valfrid/OpenAudioLink/firmware/components/oal_audio/include/oal_playout.h

#pragma once

#include <stdbool.h>
#include <stddef.h>
#include <stdint.h>

#include "esp_err.h"
#include "oal_channel.h"

#ifdef __cplusplus
extern "C" {
#endif

/*
 * Playing received audio through an I²S DAC (docs/HARDWARE.md).
 *
 * Two clocks that nobody synchronised meet here. Packets arrive when the
 * radio delivers them — measured at 1.2 to 2.3 ms of jitter, occasionally
 * in bursts (LINK-MEASUREMENTS.md) — and the DAC consumes exactly 48 000
 * frames a second forever. A buffer between them is not an optimisation;
 * without one every scheduling hiccup is an audible click.
 *
 * So received packets go into a ring, and a separate task feeds the I²S
 * peripheral from it at the rate the hardware sets. The ring's depth is
 * the playout delay, and it is the price of not clicking.
 *
 * What this does not do yet is correct drift. The sender's idea of 48 kHz
 * and this DAC's differ by a few parts per million, so over hours the ring
 * slowly fills or empties. Both ends are handled — a full ring drops its
 * oldest frames, an empty one plays silence — and both are counted, so the
 * effect is visible rather than mysterious. Trimming the clock through the
 * APLL is decision 2's work and belongs with multi-speaker synchronisation
 * rather than here.
 */

typedef struct {
    int bclk_gpio;
    int ws_gpio;
    int dout_gpio;

    /** Frames per second. The RTP profile's 48 000 unless testing. */
    uint32_t sample_rate;

    /**
     * How much audio to gather before playing any of it. The whole
     * latency argument in one number: too little and ordinary jitter
     * empties the ring, too much and the speaker lags the room.
     *
     * Set against the longest gap a sender leaves rather than the
     * network's jitter — a PC waking on a 15.6 ms timer leaves a bigger
     * hole than Wi-Fi does. Zero takes the 100 ms default.
     */
    uint32_t target_ms;

    /** Which of the two channels this speaker plays (decision 10). */
    oal_channel_t channel;
} oal_playout_config_t;

typedef struct {
    bool running;             /* the I²S peripheral is up */
    bool playing;             /* the ring is primed and feeding it */
    uint32_t buffered_frames;
    uint32_t target_frames;
    uint32_t capacity_frames;
    uint64_t frames_played;
    uint32_t silence_frames;  /* inserted because the ring ran dry */
    uint32_t dropped_frames;  /* discarded because the ring was full */
    uint32_t underruns;       /* times it ran dry, however long each lasted */
    uint32_t trimmed_frames;  /* single frames dropped to walk the fill back down */
    uint32_t write_errors;    /* the I²S driver refused a write */
    oal_channel_t channel;
} oal_playout_state_t;

/**
 * Brings up the I²S peripheral and starts the playout task. The task runs
 * and writes silence whether or not anything is arriving: a DAC needs a
 * continuous bit clock to stay locked, and one that is started and stopped
 * with the audio clicks on every track.
 */
esp_err_t oal_playout_start(const oal_playout_config_t *config);

/**
 * Hands one packet's payload to the ring, applying the channel profile on
 * the way.
 *
 * @param payload L24 big-endian stereo, **modified in place** by the
 *                channel profile. The consumer has already verified it by
 *                the time this is called.
 * @param frames  frames, not bytes.
 *
 * Safe to call before the DAC has been started; it does nothing.
 */
void oal_playout_submit(uint8_t *payload, size_t frames);

void oal_playout_get(oal_playout_state_t *out);

/** True once the I²S peripheral is up. */
bool oal_playout_running(void);

#ifdef __cplusplus
}
#endif
