valfrid/OpenAudioLink/(commit log)

2026-07-27 Add protocol suite specifications (discovery, identity, control)
    Define protocol-suite 0.1 drafts: UDP multicast discovery with JSON
    announce/probe messages, the device identity and hardware-profile
    model, and the HTTP/JSON control and status API for the Phase 2.4
    command set. Port assignments and versioning rules are documented in
    protocol/README.md.
    Claude-Session: https://claude.ai/code/session_013Ep1dr3eARSjFWME619s7Y
2026-07-27 Add Windows Hub skeleton (Phase 2.2)
    .NET 8 solution with three projects:
    - OpenAudioLink.Core: device identity model, device registry with
    liveness tracking, and the discovery wire protocol (announce/probe)
    per protocol-suite 0.1.
    - OpenAudioLink.Hub: ASP.NET Core host with health endpoint, device
    inventory API, JSON configuration storage, discovery background
    service and a web UI shell. Runs as console app or Windows service.
    - OpenAudioLink.Core.Tests: xUnit coverage for identity, discovery
    parsing and registry liveness.
    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
2026-07-27 Add ESP-IDF test firmware skeleton (Phase 2.3)
    Portable oal_discovery component implementing the announce/probe
    protocol from protocol/DISCOVERY.md, plus a testnode project that
    boots, joins Wi-Fi (build-time credentials until USB provisioning)
    and announces itself so the Hub can discover it. Builds for both the
    temporary ESP32-C3 development boards and the ESP32-S3 reference
    target; no hardware-profile-specific code.
    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
2026-07-27 Add CI: Hub build/test and ESP-IDF firmware builds
    Builds and tests the Hub solution on Windows and Linux, and builds
    the testnode firmware for esp32c3 and esp32s3 with ESP-IDF v5.3.1.
    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
2026-07-27 Hello-world milestone: provisioning portal, control server, OTA
    Firmware:
    - oal_wifi: Wi-Fi credentials in NVS with a SoftAP provisioning portal
    fallback, so nodes are configured from a phone without any toolchain
    and no credentials ever enter the repository.
    - oal_control: HTTP control server on 41001 with /status, /reboot and
    /ota (pull-based esp_https_ota into the inactive OTA slot).
    - Two-OTA partition layout; firmware version 0.2.0.
    Hub:
    - FirmwareStore: upload, list (size + SHA-256) and serve images under
    /firmware for device OTA pulls.
    - DeviceCommandClient: reboot and OTA-start commands to devices, using
    the Hub address as seen from the device's subnet.
    - Web UI: firmware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
    [main.c]
2026-07-27 Specify RTP audio transport as an AES67-subset L24 profile
    Locks the audio payload to a publicly specified format (L24, 24-bit
    linear PCM per RFC 3190, 48 kHz stereo, big-endian) described by SDP,
    so any conforming RTP receiver can decode an OpenAudioLink stream and
    third-party software can verify a Producer before receiver firmware
    exists.
    Defaults to 5 ms packets rather than the AES67 1 ms baseline: at 1 ms
    an ESP32 must service 1000 packets per second over Wi-Fi for 4 ms of
    latency a multi-room system does not need. Unicast is the default for
    the same reason, since Wi-Fi multicast is unacknowledged and sent at a
    low basic rate.
    Documents the deviations from AES67 (no PTP, no RTCP in 0.1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
2026-07-27 Record Windows audio capture decision: WASAPI loopback
    Captures the target use case (play Spotify on the PC, stream to every
    receiver, PC keeps its own sound) and settles the capture mechanism
    before Phase 3 implementation.
    WASAPI loopback on the active render endpoint needs no virtual audio
    device: local playback continues, nothing is installed and nothing is
    reconfigured in Windows. Records why a third-party virtual cable and a
    custom driver were rejected, and notes process loopback capture as the
    later answer for per-application streaming.
    Also documents the constraints that follow: capture must run in the
    logged-in session rather than the session 0 service, the endpoint mix
    format must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
2026-07-27 Add RTP audio producer with test-tone stream (Phase 3 bring-up)
    Implements the wire side of protocol/AUDIO-RTP.md so the audio path can
    be verified with third-party receivers while the ADC/DAC boards are
    still in transit, and before WASAPI capture exists.
    Core:
    - AudioStreamFormat: reference format (stereo/48 kHz/L24/5 ms) with
    validation that rejects packet times which are not a whole number of
    frames or would fragment on a 1500-byte MTU.
    - RtpAudioPacketizer: RFC 3550 header plus big-endian L24/L16 payload.
    Timestamps advance by frames written rather than wall-clock time, so
    bursty sending still produces correctly timed audio.
    - SineToneSource: phase-continuous tone, the reference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
2026-07-27 Add test tone controls to the Hub web UI
    Makes the test tone a first-class diagnostic rather than a curl-only
    endpoint. Sending a tone to a receiver answers "is this speaker
    working?" without involving a source, which stays useful long after
    bring-up.
    The destination can now be a discovered device, an explicit address, or
    omitted entirely — in which case the tone is sent back to whoever made
    the request, so the UI can start a stream aimed at the machine the
    browser is running on without the user looking up an IP. Addressing by
    device id rather than address means the tone follows a device if DHCP
    moves it.
    Claude-Session: https://clau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
2026-07-27 Add WASAPI loopback capture as an RTP source
    Captures the Windows default output device and streams it as RTP, so
    audio playing on the PC reaches the receivers while local playback
    continues. No virtual audio device, nothing to install.
    - IAudioSource abstraction; the tone and system audio now share one
    sender, so the subtle catch-up pacing exists in one place only.
    - AudioRingBuffer bridges push-style capture to the paced pull-style
    sender. Both directions of rate mismatch are explicit: a writer that
    gets ahead drops the oldest samples so live audio stays current, and a
    reader that gets ahead is given silence. Both are counted and surfaced
    in the stream status.
    - SystemAudioSourc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
2026-07-27 Fix ring buffer concurrency test
    Two problems, both in the test rather than the buffer:
    - Task.WaitAll trips xUnit1031 (blocking task operations in a test
    method), which warnings-as-errors turns into a build failure; the test
    is now async and awaits with a timeout.
    - The sample total was not an exact multiple of the chunk size, so the
    writer sent 99,968 of the 100,000 samples the assertion balanced
    against. Sizes are now derived from chunk count, since the point of
    the test is that the counts balance exactly.
    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
2026-07-27 Add enclosures to the project with a board measurement sheet
    Sets up parametric OpenSCAD enclosures as a repository component:
    source is diffable and reviewable, and CI will export STLs as artifacts
    so no CAD software is needed to get a printable file.
    MEASUREMENTS.md is the input to all of it — a datum convention plus
    twelve measurements per board, each stated with why it matters, and the
    design decisions (headers vs direct wiring, stacked vs side by side,
    closure method) that affect geometry as much as the numbers do.
    Records two constraints that come from the project rather than taste:
    the antenna keep-out, and USB access without disassembly since the
    device lifecycle ends in USB reco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
2026-07-27 Keep a live stream alive through UDP send failures
    Two changes after the first real end-to-end run, where the packet
    counter stopped while the stream was up.
    Windows fails the next operation on a UDP socket with WSAECONNRESET
    once an ICMP port-unreachable arrives — which happens whenever the
    receiver is not listening yet, restarts, or closes. That killed the
    send loop for something that is not the sender's fault, so
    SIO_UDP_CONNRESET now disables it.
    A single failed datagram also no longer ends the stream: send errors
    are counted and the loop continues, since losing one packet of live
    audio is far better than losing the stream. Persistent failures are
    visible as a count rather than silen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
2026-07-27 Refresh Hub status when the tab regains focus
    Browsers throttle setInterval in background tabs, often to once a
    minute, so switching to another window froze the packet counter while
    the stream ran normally — which reads as a stalled stream. Refreshing
    on visibilitychange and focus means the figures are current whenever
    the page is actually being looked at.
    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
2026-07-27 Allow an explicit destination address in the Hub UI
    The dropdown could only target a discovered device or the computer
    showing the page, so streaming to a machine you cannot browse from
    required the API. A typed address now covers that, and takes precedence
    over the dropdown so an explicit destination is never silently ignored.
    Also clarifies the default option: "This computer" resolves to the
    machine displaying the page, not the one running the Hub, which matters
    as soon as the two are different.
    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
2026-07-27 List every discovered machine as a stream destination
    The dropdown excluded devices with the hub role, on the assumption
    destinations would only ever be receivers. A PC running a player is
    exactly what you target when checking the audio path across the
    network, and another Hub on the LAN is discovered already — so it
    should be selectable rather than requiring its address be typed.
    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
2026-07-27 Record what the audio path has actually been verified against
    The tone, system-audio capture and a cross-machine stream over Wi-Fi
    have all been confirmed against GStreamer as an independent receiver.
    Writing down what was exercised — and what was not — matters more than
    usual here, because the compiler and CI cannot tell the difference
    between code that works and code that merely builds.
    Also states plainly that a stream currently has a single destination,
    where the architecture calls for one Producer feeding several
    Consumers.
    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
2026-07-27 Stream to multiple destinations by unicast replication
    A Producer can now feed several Consumers, which is what multi-room
    actually requires. Every destination receives the identical packet —
    same SSRC, sequence and timestamp — so receivers applying the same
    playout delay stay aligned with each other. One unreachable receiver no
    longer ends the stream for the rest.
    Destinations are given as a list where each entry is either a device id
    or an IP address: naming a device means the address follows it if DHCP
    moves it, while a literal address covers machines that are not
    OpenAudioLink devices at all, such as a PC running a player. With none
    given the caller is the destination, so the browse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
2026-07-27 Record source-placement rationale and future radio roles
    Captures why the Hub exists at all — Spotify Connect cannot run on an
    ESP — and that the founding use case was a vinyl rig streaming to party
    speakers with no PC involved. That history is what makes the Hub
    optional a return rather than a new direction, and it was recorded
    nowhere.
    Adds internet radio and DAB as future Producer roles. Both fit the
    existing role model without architectural change, but they are
    different engineering problems: internet radio is pure software on the
    ESP, while DAB needs an RF tuner module feeding I2S and then resembles
    the Analog Source.
    Notes the two things worth settling before committing to intern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
2026-07-27 Place internet radio on Windows rather than either platform
    Decoding competes with unicast replication for one chip and one radio,
    while a PC already has the headroom that makes stream buffering robust.
    An ESP32 implementation stays possible but is not the plan, and nothing
    is scheduled either way.
    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
2026-07-27 Send the firmware console to the native USB port
    Both the ESP32-C3 and ESP32-S3 talk to a PC over their built-in USB
    Serial/JTAG peripheral, but ESP-IDF defaults the console to UART0 —
    which on the Super Mini boards is not wired to the USB connector. The
    board therefore ran correctly and printed nothing at all, which makes
    every other problem undiagnosable.
    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
2026-07-28 Make the test node diagnosable on real hardware
    Three changes, all prompted by a C3 that ran and could not tell anyone
    what it was doing.
    start_portal checks each call individually and logs which one failed,
    instead of ESP_ERROR_CHECK aborting silently. A device that cannot start
    its setup portal is unrecoverable in the field, so it must report the
    reason rather than reboot. The soft-AP channel is now set explicitly,
    since 0 is not valid on all IDF versions.
    A heartbeat task logs uptime, free heap and Wi-Fi mode every five
    seconds. USB Serial/JTAG keeps no buffer for a terminal attached after
    boot, so a console opened during normal running was completely blank and
    indistinguishable from a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
    [main.c]
2026-07-28 Record deployment modes and the capacity order of attack
    Standalone "party mode" is a distinct deployment, not a fallback: gear
    carried to a venue with no router, no Hub and no internet, where the
    Producer creates its own access point and receivers join it. It reuses
    the soft-AP already built for provisioning as an operating mode, and is
    the strongest test of the Hub-optional decision — if it works, no hidden
    dependency on the Hub survived.
    Notes the open question it raises: a receiver configured for a home
    network must join the party network unattended, which suggests a
    fallback chain of configured network, then an OpenAudioLink access
    point, then its own setup portal. Recognising an Ope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
2026-07-28 Record single-image, role-in-NVS design with S3 as the only baseline
    A node runs one firmware image with its role read from NVS at boot
    rather than compiled in, written during provisioning and defaulting to
    receiver. Roles are logical rather than device-bound, so baking one into
    a binary contradicts the architecture; it also means OTA cannot push the
    wrong role, the firmware store holds one image, and a node changes role
    by configuration instead of a USB trip.
    Staying on one chip is what keeps it to a single image for the whole
    system — mixed silicon would mean two forever. The C3 is recorded as
    temporary scaffolding with an explicit removal trigger rather than
    something left to drift.
    F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
2026-07-28 Adopt Seeed XIAO ESP32S3 as the preferred node hardware
    External U.FL antenna with no PCB antenna at all, dual-core 240 MHz,
    published schematics and mechanical models, and integrated Li-Po
    charging. The antenna removes the enclosure keep-out constraint outright
    rather than requiring design around it, the dual core is the property
    decision 2 relies on, published mechanical data feeds the enclosure work
    directly, and battery charging turns standalone party mode from a
    mains-tethered idea into a portable one.
    Hardware profiles now name the board as well as the audio hardware,
    since pin mapping and antenna arrangement both differ between boards.
    The Super Mini becomes secondary and the C3 keep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
2026-07-28 Log why provisioning fails to persist
    The node stays in soft-AP mode after credentials are entered, so it
    never joins the network and never reaches the Hub. Neither the save nor
    the load path said anything, leaving no way to tell which one failed.
    - load_credentials now reports whether NVS opened, whether an SSID was
    found, and the error when not.
    - The save handler logs the content length, reads the body until the
    declared length is satisfied rather than assuming a single read, and
    reports a missing ssid field with its parse error.
    - A boot-time NVS erase is now logged loudly, because it silently
    discards stored credentials — if it happens every boot the device can
    never be pro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
    [main.c]
2026-07-28 Fix provisioning form rejected by mobile browsers
    Two separate faults stopped credentials ever reaching NVS, both visible
    in the device log as HTTP errors rather than anything about storage.
    405: the phone submits the form as GET, putting the fields in the query
    string, and only POST was registered for /save. Both shapes are now
    accepted — rejecting one leaves the user unable to provision the device
    at all, which is not a reasonable place to be strict.
    431: ESP-IDF's HTTP server allows 512 bytes of request headers by
    default, and a modern mobile browser exceeds that easily with its
    User-Agent, Accept and sec-ch-* headers. Requests were rejected before
    any handler ran. Raised to 2048, wit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
2026-07-28 Report node state in every heartbeat, not just at boot
    Catching the boot log over native USB is unreliable: the port dies with
    each reset and the console reattaches after the interesting lines have
    already gone, so whether the access point actually started was
    unknowable from a console opened afterwards.
    The heartbeat now carries the answer — in AP mode the SSID, channel and
    client count; in STA mode the joined network, RSSI and IP address, or
    that it is not joined. Connecting at any moment now tells you the node's
    full network state instead of a bare mode number.
    Claude-Session: https://claude.ai/code/session_013Ep1dr3eARSjFWME619s7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
    [main.c]
2026-07-28 Add a radio self-check to the setup portal
    The access point reports as configured and started — esp_wifi_ap_get_sta_list
    succeeds rather than erroring — yet nothing can associate with it even
    when given the exact SSID manually. That separates logic from radio, and
    nothing in the logs distinguishes a working transmitter from a broken one.
    The node now scans once after the portal comes up and logs the networks
    it can hear with channel and RSSI, plus its own maximum transmit power.
    Hearing the surrounding networks proves receive works and points at
    transmit, antenna or association; hearing nothing in a normal home
    implicates the radio itself. The portal runs in AP+STA so the scan is
    possib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
2026-07-29 Revert the portal to plain AP mode so DHCP works
    The radio self-check needed the station interface up in order to scan,
    so the portal was switched to AP+STA. With both interfaces active a
    client associates at layer 2 but the access point's DHCP server never
    issues a lease: the phone joins, waits, reports that it could not
    connect, and drops the network. The join appears in the log with no
    DHCP assignment after it.
    The self-check has served its purpose — flashing ESPHome onto the first
    board established that its transmitter was faulty — so the scan is
    removed rather than worked around, and only the transmit-power report is
    kept.
    Cla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
2026-07-29 Bump test node firmware to 0.2.1
    The running build and the next one were both 0.2.0, so an over-the-air
    update would complete with nothing in the Hub's device table changing —
    leaving no way to tell whether it actually installed. The version is
    what makes an OTA verifiable from the UI, so it moves with this build,
    which also carries the AP-mode DHCP fix.
    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
    [main.c]
2026-07-29 Add Windows service install scripts for the Hub
    A machine that hosts the Hub permanently should run it as a service that
    survives reboots, so the artifact now ships install and uninstall
    scripts.
    The service starts automatically (delayed, so the network stack is up
    before discovery binds its multicast socket) and restarts after a crash.
    State goes to ProgramData rather than beside the executable, so
    re-running the installer to upgrade keeps the Hub's identity and
    uploaded firmware. Firewall rules for the web UI and discovery are
    created too, since a headless server has nobody to click the prompt.
    Documented alongside it: capturing the machine's audio does not work
    from a service, because s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
2026-07-29 Record that multiple Hub instances are a normal deployment
    A server instance running as a service handles Controller and
    Provisioner work, while any PC whose audio should be streamed runs its
    own instance in a logged-in session — forced by capture not working in
    session 0, and consistent with roles being logical rather than tied to
    devices.
    Choosing which roles an instance takes is deferred; every instance
    offers what it can for now. Notes the consequences that follow: Hubs
    appear to each other as devices, there is no single Controller, and
    nothing yet stops two instances streaming to the same receiver — which
    the receiver-held claim from decision 1 is meant to resolve, for Hubs
    exactly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
2026-07-29 Document PowerShell friction around the service installer
    Running the installer needs three things the earlier instructions did
    not mention, all of them PowerShell behaviour rather than ours: the .\
    prefix, since PowerShell will not run a script from the current
    directory without an explicit path; Unblock-File, because scripts
    extracted from a downloaded zip carry the internet mark and are refused
    under the default RemoteSigned policy; and an elevated prompt, without
    which the script stops immediately.
    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
2026-07-29 Correct the Set-ExecutionPolicy syntax in the service instructions
    Bypass is a value for -ExecutionPolicy rather than a switch, so the
    documented command failed with a parameter binding error. Also notes
    that an elevated prompt opens in system32, so the cd is needed even when
    the previous window was already in the right folder.
    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
2026-07-29 Reject firmware uploads that cannot be installed over the air
    The merged flash image and the OTA application image both begin with the
    same 0xE9 magic, so uploading the wrong one was accepted silently and
    then failed on the device — where it is far more expensive to diagnose.
    An ESP-IDF application image carries an esp_app_desc_t whose magic word
    sits at offset 0x20; a merged image has the bootloader there instead.
    Checking that distinguishes them exactly, and the rejection message
    names the file to upload instead.
    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
2026-07-29 Probe devices periodically so liveness survives multicast loss
    A node joined and announcing every five seconds still showed offline in
    the UI: announces are multicast, and Wi-Fi neither acknowledges nor
    retransmits them, so at around -70 dBm enough are lost that a healthy
    device flaps. The same reasoning that made unicast the default for audio
    applies to the control plane, and had not been carried across.
    The protocol already had the answer — devices reply to a probe by
    unicast — but the Hub only probed at startup. It now probes every five
    seconds, by multicast to find new devices and by unicast to those it
    already knows, so both the request and the reply get link-layer retries.
    No firm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
2026-07-29 Stop the API being served from browser cache
    Device liveness and stream counters are only useful if they are current,
    and a cached reading is indistinguishable from a dead device — which is
    exactly the ambiguity that made a flapping node hard to diagnose. API
    responses now carry no-store, and the UI's own fetches ask for it too.
    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
2026-07-29 Serve OTA from an address the device can reach
    The Hub picked the firmware URL host by connecting a UDP socket to the
    device and reading the socket's local address. That asks the routing
    table which interface it prefers, which is a different question. On a
    host running Tailscale it returned the CGNAT address 100.119.101.42, so
    the node was told to fetch from an address that does not exist on its
    network and the download failed at connect:
    E esp-tls: [sock=59] delayed connect error: Software caused connection abort
    E esp_https_ota: Failed to open HTTP connection: ESP_ERR_HTTP_CONNECT
    Choose by subnet instead: of this host's addresses, use one whose network
    contains the device — reacha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
2026-07-29 Show which version a firmware image contains
    An OTA that installs the version already running completes normally,
    reboots, and leaves the device reporting what it reported before — the
    node just did exactly that, taking a stale CI artifact from 0.2.0 to
    0.2.0. Nothing in the Hub distinguished that from an update that worked.
    The image header carries an esp_app_desc_t with the version, project
    name, build time and IDF version. Read it and show version and build
    time in the firmware table, and the version in the image picker, where
    choosing the wrong file is still recoverable.
    For that to mean anything the header version has to be the version the
    node announces, and it was not: FIRMWARE_VE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
    [main.c]
2026-07-29 Join the strongest mesh node, not the first to answer
    In a mesh every node advertises the same SSID under a different BSSID,
    so joining the network means choosing between them. The STA config was
    zero-initialised, which selects WIFI_FAST_SCAN: the driver takes the
    first node that answers and never compares. sort_method is ignored in
    that mode — there is nothing to sort — so the WIFI_CONNECT_AP_BY_SIGNAL
    that the zeroed struct also happens to select did nothing.
    The driver probes its remembered channel first, so a node that once
    landed on a distant mesh point goes back to it after every reboot. A
    test node 2 m from one ZenWiFi point sat at -77 dBm on the far one,
    having read -55 on the n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
    [main.c]
2026-07-29 Keep discovery alive when a device reboots
    Probing devices by unicast means regularly sending to a device that is
    rebooting — after an update, especially — and a rebooting device answers
    with ICMP port-unreachable. Windows fails the next operation on the
    sending UDP socket with WSAECONNRESET. RtpStreamer already suppresses
    that; the discovery socket never did, and it is the socket the Hub hears
    every other device on.
    The damage was in the loops. ProbeLoopAsync caught Exception, logged
    "Probe loop stopped" and left the loop, so one send to a rebooting node
    ended probing permanently. AnnounceLoopAsync caught only cancellation, so
    a SocketException escaped into Task.WhenAll and faulted Exe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
2026-07-29 Bind test sockets to loopback, not the any-address
    The new discovery socket tests bound with UdpClient(0, InterNetwork),
    whose LocalEndPoint is 0.0.0.0 — so they sent to 0.0.0.0. Windows
    rejects that with WSAEADDRNOTAVAIL; Linux reads it as localhost, which
    is why only the Windows leg failed. Bind to loopback so the endpoint is
    a real address to send to.
    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
2026-07-29 Hold node roles in NVS as a set, in the architecture's words
    Decision 5 says one firmware image with the role read from NVS. Two
    identical S3 boards where one sends and one receives is the case that
    forces it, so this stops being deferred work.
    Two things were called "role". ARCHITECTURE.md section 2 defines
    capabilities — controller, producer, consumer, provisioner — and says a
    device may implement several. The wire had a single string with a
    different vocabulary: receiver, analog-source, hub. One concept, two
    names, and the single field could not express the analog source that
    also plays, which decision 5 requires.
    The wire now uses the architecture's names and carries a set. Roles l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
2026-07-29 Import DeviceRole in the discovery message tests
    The rename put DeviceRole.Consumer into a file that did not reference the
    Devices namespace, so only the test project failed to compile.
    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
2026-07-29 Measure the link: RTP loss, jitter, duplicates and reordering
    The instrument for the ESP-to-ESP test. A consumer with no DAC attached
    can still answer what decides the architecture: whether a producer holds
    200 packets per second with a busy radio, what an RSSI costs in loss, and
    how deep a jitter buffer must be.
    Loss and jitter follow RFC 3550 appendices A.1 and A.8, so the numbers
    mean what every other RTP tool means by them. Duplicates and reordering
    are counted separately, which RFC 3550 does not do — on Wi-Fi they have
    different causes and different fixes, and one number hides which is
    happening. A 64-bit window of recent sequence numbers is what tells them
    apart.
    Three cases would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
    [oal_rtp_stats.c, oal_rtp_stats.h]
2026-07-30 Record alternative Consumers as decision 8
    ARCHITECTURE.md lists "I2S DAC output" under the Consumer's
    responsibilities, which reads as though the role dictates the output. It
    does not: a Consumer receives RTP, buffers it, corrects drift and plays
    it, and how samples leave the device belongs to the hardware profile.
    Alternative Consumers are therefore additive — new profiles, not a new
    architecture.
    Three are recorded so they are not re-derived later: a USB Audio Class
    dongle DAC driven by an ESP32-S3 in host mode, a PC Consumer
    application, and a Raspberry Pi.
    The USB option carries the obstacles, and they are written down because
    they decide whether it is worth attempting at all. VBUS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
2026-07-30 Name nodes by MAC suffix so identical boards are distinguishable
    One firmware image runs on every node (decision 5), so two boards
    flashed from the same file both announced "testnode". Their ids differ,
    so the Hub keeps them apart correctly, but the device list shows two
    identical rows and the stream destination list offers the same name
    twice — with two S3 boards on the bench, no way to tell the producer
    from the consumer.
    Append the same three MAC bytes that already name the setup access
    point, so a node in the device list is recognisably the one just
    provisioned through OpenAudioLink-XXXXXX.
    Claude-Session: https://claude.ai/code/s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
    [main.c]
2026-07-30 Build the portal SSID from the station MAC, like everything else
    The MAC suffix was meant to make the network you provision through and
    the node that then appears recognisably the same board. It did not: the
    portal read ESP_MAC_WIFI_SOFTAP while the identity and node name read
    ESP_MAC_WIFI_STA, and those differ by one in the last byte. A board with
    base MAC 1c:db:d4:43:54:58 offered OpenAudioLink-435459 and then
    announced itself as testnode-435458 — close enough to look like the same
    number and different enough to send you to the wrong board.
    One source for the label, the same one identity already uses.
    Claude-Session: https://claude.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
2026-07-30 Ask for name and role at provisioning, and let the password be seen
    Provisioning is the one moment the board is in your hands and you know
    which one it is. It now asks for everything that distinguishes it — the
    network, a name, and what the node is for — instead of only the network,
    so two identical boards become a producer and a consumer without a
    second trip through the Hub afterwards.
    The password can be revealed with a checkbox. It is typed once, alone,
    in front of a board, and a silent typo costs a failed join and a full
    re-provision cycle; that is a worse outcome than the nobody standing
    behind you.
    Name and roles are stored in NVS beside the credentials. Both are
    optional: the f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
    [main.c]
2026-07-30 Drop the ESP32-C3 target and size the flash to the real board
    Decision 5 removed the C3 target on a trigger — S3 hardware verified —
    rather than by drift. Two XIAO ESP32S3 boards are flashed, provisioned
    from a phone, discovered by the Hub and holding distinct producer and
    consumer roles from one image, so the trigger is met.
    With one target left, the partition table can be sized to the board
    instead of to the smallest chip that ever ran this. The flashing log
    confirmed what decision 6 could not: flash ID 0xC84017 is GigaDevice
    with capacity byte 0x17, so 8 MB, alongside 8 MB embedded PSRAM.
    The built-in two-OTA table caps every app partition at 1 MB whatever the
    chip, which is why the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
    [partitions.csv]
2026-07-30 Show uptime, SSID, BSSID and signal in the device list
    Diagnosing a mesh from a serial console one board at a time is how the
    last two evenings went. The device list now carries what those sessions
    were actually looking for.
    The BSSID is the point, not the RSSI. Every access point in a mesh
    advertises the same SSID, so signal strength alone cannot tell a node far
    from the right node from one attached to the wrong one — which is exactly
    the state a board sat in at -77 dBm two metres from a stronger point, and
    it took a firmware change to even see it. Signal is coloured against what
    a stream needs: a 2.4 Mbit/s unicast has margin above about -65 dBm and
    none below -75.
    This goes on the con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
2026-07-30 Stream RTP between nodes from a synthetic source
    The measurement rig for the link, ahead of the ADC and DAC. A producer
    generates the real profile — L24 stereo, 48 kHz, 5 ms packets, 200 a
    second, 1452 bytes on the wire — and sends it straight to the consumers
    the Hub names. The Hub coordinates and does not relay.
    The synthetic source is a pattern derived from each frame's absolute
    index, not a tone. A consumer can recompute every sample it should have
    received and count what differs, which catches corruption, truncation
    and misaligned payloads that a sequence-number check cannot see. A sine
    is available for when a DAC exists and something is worth listening to.
    Both ends report, becau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
    [main.c, oal_rtp.c, oal_rtp.h, oal_stream.h, oal_stream_consumer.c, oal_stream_producer.c]
2026-07-31 Put the link test's feedback under the link test
    Pressing Start with nothing selected in the To list wrote "Pick at least
    one destination" to the shared message line — which sits below the
    Firmware section, three screens away. From the panel the button simply
    looked dead.
    Messages for this panel now go to the status line directly beneath it,
    in red when something is wrong.
    The list also selects every consumer the first time it is populated.
    Testing all of them is the common case, and a populated list with
    nothing selected looks identical to a populated list with everything
    selected — which is precisely the state that made Start appear to do
    nothing.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
2026-07-31 Turn off Wi-Fi power save; it is costing packets
    The first measured link between two nodes on the same access point at
    -61 dBm lost 0.24% of packets and showed 2.04 ms of jitter. That is 220
    ms of missing audio over 92 seconds, a gap every two seconds, and far
    worse than the signal deserves.
    Every boot log has carried "wifi:pm start, type: 1" — modem sleep. The
    radio wakes on the beacon and the access point buffers unicast frames in
    between. That suits a device exchanging occasional control messages and
    is actively wrong for one taking 200 packets a second, and it fits the
    signature: steady low-level loss with inflated jitter and no reordering
    or corruption at all.
    The producer meanwhile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
2026-07-31 Measure the shape of the loss, not only the amount
    Turning off power save halved it: 0.240% to 0.111%, jitter 2.04 ms to
    1.19 ms. Real, and not enough — 38 packets is still 190 ms of missing
    audio over 171 seconds.
    But the total does not say what to do next. Thirty-eight isolated single
    packets are thirty-eight 5 ms gaps, which concealment hides almost
    inaudibly. The same thirty-eight arriving as four bursts of ten is four
    quarter-second dropouts, which only forward error correction or a much
    deeper buffer survives. One number, two completely different engineering
    answers, and no way to tell them apart until now.
    Gaps are counted where they appear rather than per missing packet, so a
    bur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
    [oal_rtp_stats.c, oal_rtp_stats.h]
2026-07-31 Stop counting the producer's own refusals as network loss
    At 20 MHz the link lost nothing over the air. 43,364 datagrams left the
    producer and 43,363 arrived, the difference being the packet RFC 3550
    probation withholds — a perfect run over 217 seconds.
    The 15 packets the consumer reported missing had never been sent. The
    producer's own row showed 43,379 attempted against 43,364 sent, and
    exactly 15 send errors. sendto refused them, and without the producer's
    counters beside the consumer's that would have read as a radio problem
    and sent us tuning the wrong thing.
    The cause is the transmit buffer pool. At 200 packets a second the
    default 32 dynamic buffers run short, which is a momentary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
    [oal_stream.h, oal_stream_producer.c]
2026-07-31 Say which access points a link test actually crossed
    Two comparisons in a row were confounded by topology rather than by what
    was being changed. Stations never talk directly under Wi-Fi
    infrastructure mode, so a packet always goes node -> access point ->
    node; when the two nodes sit on different mesh points it crosses the
    backhaul too, which is a third hop.
    The nodes are 20 cm apart and roughly equidistant from both ZenWiFi
    points, so which one each picks is close to arbitrary and changes across
    a reboot. A channel change that also moved one node to the other access
    point looked like the channel being worse.
    The link status line now names the access points involved and says
    plainly whether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
2026-07-31 Record what the link measurements established
    Seven runs, three of them invalidated by confounds that were only visible
    in hindsight. The findings worth keeping: power save costs packets, the
    channel choice is first-order and the usual 1/6/11 advice did not apply
    here, the mesh backhaul hop costs roughly six times the loss, and every
    loss so far has been a scattered gap of one to five packets rather than a
    burst. Nothing has ever arrived corrupted.
    Also records the two ways a run can lie — a producer's refused sends
    counted as network loss, and nodes that split across mesh points turning a
    channel comparison into a topology comparison — since both cost several
    measurements before being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
2026-07-31 Wait real time for a transmit buffer instead of yielding
    Retrying a refused send after taskYIELD() still lost five packets in
    thirty-four thousand with the buffer pool already doubled. Yielding does
    not wait: the producer task runs above anything that would be scheduled
    instead, so it returns immediately and finds the pool as empty as it left
    it. Buffers are freed when the driver completes a transmission, which
    takes hundreds of microseconds.
    Retry against a deadline in 250 us spins instead. The time is already
    there — the loop spends the tail of every interval spinning for the next
    deadline anyway — and the driver task, being higher priority, runs during
    the wait.
    Each destination get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
2026-07-31 Block instead of spinning; the producer was starving its own stack
    Retrying a refused send in busy-wait spins made things three hundred times
    worse: 434 refusals in 8,697 packets, against 5 in 34,045 before. The air
    lost nothing — consumer loss equalled producer send errors exactly — so
    every one of those packets was refused locally.
    sendto() takes the lwIP core lock, and the thread that recycles transmit
    buffers needs the same lock. Spinning between calls never released the
    CPU, so the retries contended with the recycling they were waiting for.
    Two changes. Wait out a refusal with vTaskDelay, which blocks and lets the
    stack run. And raise CONFIG_FREERTOS_HZ to 1000, which is what make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
    [oal_stream_producer.c]
2026-07-31 Revert the producer to 0.6.3 and show why sends are refused
    Two attempts to reduce refused sends both made them dramatically worse:
    0.015% at 0.6.3, 5% spinning at 0.6.4, 29% blocking at 1 kHz tick at
    0.6.5. Air loss was zero in all three — the consumer's loss equalled the
    producer's refusals exactly every time — so each regression was entirely
    self-inflicted. Restore the producer and the tick rate to what measured
    0.029% air loss and stop guessing.
    The guessing was avoidable. The node has been reporting lastSendErrno and
    sendRetries since the counters were added, and the UI showed neither, so
    three revisions were spent inferring the cause from a single number.
    Show both: which errno re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
    [oal_stream_producer.c]
2026-07-31 Record the false trail and the baseline that came back
    Four more runs. Three of them chased a regression that turned out to be
    the radio environment degrading over an evening, including one on
    firmware byte-identical to the run it contradicted. The fourth, after
    restarting everything, refused nothing at all and recorded the lowest
    jitter yet on the same image.
    The lesson is worth more than the numbers: a refused send is a symptom of
    a channel that will not clear, not a defect in the sender, and a
    measurement that contradicts a known-good baseline is a claim about the
    environment until the baseline is re-established. Adds both to the method,
    along with measuring A, B, then A again when compa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
2026-07-31 Test the tick change on its own
    0.6.5 bundled a blocking retry with CONFIG_FREERTOS_HZ=1000 and measured
    359 refusals and 10.83 ms of jitter against a baseline of zero and 1.04 ms
    an hour earlier. That condemns the retry, which is already reverted, but
    says nothing about the tick — the two were never separated.
    0.6.7 is 0.6.6 plus the tick and nothing else; send_one is byte-identical
    to the version that measured 0.045% air loss with no refusals at all.
    The tick matters beyond this: at 10 ms the producer's vTaskDelay could
    never sleep a whole tick against a 5 ms packet, so the task busy-spun the
    whole interval and never blocked. The pacing loop now holds one tick back
    rather than sleeping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
    [oal_stream_producer.c]
2026-07-31 The receiver and the cast point are one object
    Treating a streaming receiver as a source that happens to sit beside a
    destination list gets the feature wrong. Choosing "Kitchen" in Spotify has
    to pick what plays and where it plays in a single act; a design where the
    user selects a generic receiver and then chooses a room somewhere else is
    two steps in two apps to do what a Chromecast does in one.
    So the Hub owns each receiver's lifecycle — spawn, name, rename, restore,
    stop — and the receiver drives the stream rather than the Hub UI. The
    consequence worth holding onto is that in normal use nobody opens the Hub
    at all: it is for naming rooms and choosing speakers, and every day after
    tha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
2026-07-31 The Consumer initiates the join; the Controller decides
    A rule that a Consumer stands down when it sees a Controller has a hole:
    in a party system the Controller is the turntable, so every Consumer would
    see one, wait, and nothing would ever play. Dropping the condition fixes
    it. The Consumer always defers to the Controller and never needs to know
    whether that Controller is a turntable or a PC — what differs is only the
    answer, which is the same layering as the default cast point.
    Consumer-initiated also beats the Producer scanning that this decision
    implied an hour ago: a scanning Producer can start sending to a node that
    is still booting, whereas a Consumer speaks when it is actually re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
2026-07-31 Discard combining marks instead of treating them as word breaks
    Decomposing before slugging folds accented names without a translation
    table, but only if the mark the decomposition produces is thrown away.
    Left in place it counted as a separator, so "Kök" slugged to "ko-k" and
    "Övervåningen" to "o-verva-ningen".
    The two tests that failed were the two that had accents in them, which is
    the reason for writing Scandinavian names into the test data rather than
    treating them as an edge case.
    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
2026-07-31 Nodes remember the peers they hear, instead of discarding them
    Announcements from other nodes were already arriving on the discovery
    socket and being thrown away: the receive path tested for a probe and
    ignored everything else, so every node knew the network existed and
    nothing about who was on it. That is workable only while a PC holds the
    Controller role. A party system has no PC (decision 9), and a Controller
    that cannot see the speakers cannot route to them.
    The table lives in oal_peers.c with no ESP-IDF headers, following
    oal_rtp_stats: what it decides — who is still present, which slot a new
    node takes, whether a re-announce updates or duplicates — surfaces on
    hardware as a Contro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
2026-08-01 A Producer's destinations can change while it streams
    The list was copied when the stream started and never revisited, so a
    speaker switched on halfway through a record had to wait for everyone
    else's music to be restarted. A Consumer joins by asking rather than by
    having been present when the music began (decision 9), which that made
    impossible.
    The send loop cannot take a lock per packet and cannot read the set
    without one, so it keeps a resolved copy and reloads only when a
    generation counter moves — two hundred times a second the common case
    touches no lock at all. The counter is read inside the lock alongside the
    copy: read outside, a change landing between the two would leave the lo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
    [oal_destinations.c, oal_destinations.h, oal_stream.h, oal_stream_producer.c]
2026-08-01 Four channel profiles, chosen at the node rather than in the stream
    The RTP profile stays stereo and byte-identical to every destination,
    because that identity is what lets several speakers stay in step. Which of
    the two channels a node plays is a property of the node: stereo, mono,
    left or right.
    Records that stereo beats a left/right pair whenever cabling allows. One
    node's two channels leave one DAC on one clock and cannot drift from each
    other; two nodes playing the halves of a stereo image are two crystals,
    and a wandering image is more audible than a wandering pitch. Left and
    right are for speaker positions too far apart to cable to one box.
    Two traps written down before anyone hits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
2026-08-01 Speaker profiles: stereo, mono, left, right
    A single mono or one-side speaker is a first-class arrangement for a
    wireless audio system, not a degraded stereo one, so decision 10 gets an
    implementation. The stream stays stereo and byte-identical to every
    destination — that identity is what lets several speakers stay in step —
    and what a node does with the two channels becomes a node setting stored
    in NVS beside its roles.
    The arithmetic is in oal_channel.c with no ESP-IDF headers and ten host
    tests, because it is worth proving before the DAC exists: mono halves
    before it sums, since two channels near full scale sum past full scale and
    the crack arrives exactly when a listener is paying a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
    [oal_channel.c, oal_channel.h]
2026-08-02 Record the longest clean run: 104,013 packets through two live changes
    Nearly nine minutes with nothing refused, nothing lost and not one gap
    recorded — while the destination set changed twice underneath it. A second
    destination was added for about seventy seconds and then removed, which the
    producer's counters show as 104,006 packets against 117,954 datagrams, and
    which the consumer already listening did not notice at all.
    That is the property decision 9 needs: a speaker switched on halfway
    through a record joins what is already playing instead of interrupting it.
    The rejection path checks out too. An address that is not a dotted quad is
    refused and counted rather than stored, so the ty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
2026-08-02 A Consumer joins by asking, and a Producer takes charge when nobody has
    The last piece of decision 9. A speaker that finishes booting finds the
    Controller, says it is ready, and does as it is told; a turntable that
    finds nobody holding the role takes it. Between them a party system needs
    no PC and no configuration beyond the Wi-Fi provisioning that already
    Precedence rather than an election protocol: every node computes the same
    answer alone from announcements already on the wire, with no votes, no
    terms and no split-brain to recover from. A configured Controller outranks
    one that merely claimed, and among equals the lower id wins — arbitrary,
    but total and identical everywhere, w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
2026-08-02 Say who a node thinks is in charge, and what it was told
    With a Hub present the join handshake is correct precisely when nothing
    happens: the Consumer asks, the Hub answers stand by, and silence follows.
    That is indistinguishable from the feature not working, and there was no
    way to ask a node who it was listening to.
    /status now reports the Controller it settled on and the last answer it
    received, and the Hub shows both in a Follows column. A node that has found
    no Controller says so in amber, because that is the state where nothing can
    reach it and it would otherwise look the same as standing by.
    Claude-Session: https://claude.ai/code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
2026-08-02 Announce on every interface, not whichever one Windows prefers
    No node has ever had the Hub in its peer table. The Hub joined the
    discovery group and sent to it without naming an interface, so the
    operating system chose by routing metric — and on a machine running a VPN
    the VPN adapter routinely wins. The same preference once sent an OTA URL
    to a Tailscale address.
    Receiving happened to land on the right adapter, which made this hard to
    see: the Hub knew every node and no node knew the Hub. The house case of
    decision 9 cannot work at all in that state, because a Consumer cannot ask
    a Controller it has never heard from.
    Join on every usable interface and name the interface on each send. I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
2026-08-02 Holding Controller no longer means being the Hub
    A turntable that claimed the role (decision 9) appeared in the device list
    with no uptime, no Wi-Fi, no signal and no buttons — the Hub had stopped
    polling it and the page had hidden its actions, both because they tested
    for the Controller role and that used to mean the Hub. It stopped meaning
    that the moment a node could take the role, and the result was a node that
    took charge becoming one nobody could watch or reconfigure.
    Poll on identity instead, and identify another Hub by what it runs on
    rather than by what it holds.
    Also separates "did not say" from "found nobody". Firmware older than 0.8.1
    does not report a Controller at all, and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
2026-08-02 Announce to known devices directly, not only to the group
    Multicast is how a device is found the first time, and it is the one
    direction never proven to work: the Hub hears every node while no node has
    ever heard the Hub. Naming the outbound interface should fix that, but it
    leaves a node knowing about the Hub depending on multicast egress
    selection on a machine where that selection has already been wrong twice.
    The Hub has a unicast path to every node it has heard from. It probes and
    controls them over it, and that path has always worked. Using it for the
    announce as well removes the dependency rather than repairing it: a node
    learns about the Hub over the same channel the Hub uses for eve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
2026-08-02 A Controller says where it is instead of letting the network guess
    A node records a peer's address from the datagram's source, which is right
    for a device announcing for itself on its own segment and wrong the moment
    anything rewrites it. On a machine running a VPN that accepts a subnet
    route for the local network, traffic to the nodes leaves through the tunnel
    and returns SNATed by the subnet router — so every node recorded the Hub at
    the router's address and would have addressed the Controller at a machine
    running nothing.
    Nothing about that looks wrong from outside. The Hub is discovered, with
    the right id, name, roles and port; only the address is another host's, and
    joining could nev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
2026-08-02 Record why a discovered device may still be unreachable
    A laptop had accepted a VPN subnet route for its own LAN, advertised by a
    node on a remote network using the same range, and the subnet router NATed
    what it forwarded. Nodes recorded the Hub at the far network's router. The
    Hub appeared in every peer table with the correct id, name, roles and port;
    only the address belonged to a machine running nothing.
    What hid it is that every direction ever used still worked. Polling,
    firmware pushes and stream control are all Hub to node. Nothing needed to
    reach the Hub until a Consumer had to ask a Controller to join, so the
    fault had been latent for the whole life of the project and surfaced the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
2026-08-02 Decision 9 verified on hardware, both deployments
    House: both nodes elected the Hub, the turntable dropped a claim it was
    already holding, and the speaker was told to stand by — correct, since the
    Hub knows about rooms and nobody had pressed play.
    Party: with the Hub stopped, the turntable claimed the role within one
    announce interval, the speaker joined it, and the speaker was already in
    the turntable's destination list. Asking is what put it there.
    Records that almost none of the effort was the handshake. The node-to-Hub
    direction had never been exercised — everything the Hub does is outbound —
    so a VPN subnet route NATing the local network had been latent for the
    project's whole l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
2026-08-02 Offer each cast point to Spotify and let it drive the stream
    The Hub now runs one librespot per cast point, named after it, so
    "Kitchen" and "House" appear in a phone's Spotify device picker and
    choosing one picks what plays and where it plays in a single act. That
    binding is the feature; a design where the user selects a generic
    receiver and then chooses a room somewhere else has lost before it
    starts.
    The receiver drives the stream, not the Hub's page. Audio starting to
    come out of a receiver starts RTP to that cast point's speakers, and five
    seconds without it stops them. Flow control is the pipe itself: the
    reader stops at 100 ms of buffered audio, librespot blocks, and what is
    held bec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
2026-08-02 Add a from-nothing guide to building librespot on Windows
    Written for someone who has never set up a Rust build, because that is
    who has to do it once before any of this plays music.
    It opens by ruling out WSL. The instinct to reach for it is reasonable —
    this is an open-source Rust program and those feel like Linux things —
    but WSL builds Linux binaries, and the Hub starts librespot as a Windows
    child process. The result would run fine inside WSL and be invisible to
    the Hub, which is a miserable thing to work out on your own.
    Two steps carry most of the risk and both get their own warning. The
    firewall is one: with the Hub running as a service there is no desktop to
    show the allow dia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
2026-08-02 Give the librespot binary a four-step command-line test
    Ordered so the first failure names the problem. Version, then options,
    then discovery, then audio — each one proving strictly more than the last.
    The useful one is 7.3, which needs no phone at all. Pinning
    --zeroconf-port makes the receiver's own discovery endpoint reachable at a
    known address, so curl asking it /?action=getInfo gets back the same JSON
    a phone would. That splits "librespot is broken" from "the network cannot
    reach it", which is otherwise a guess.
    It also warns to type curl.exe. Plain curl in PowerShell is
    Invoke-WebRequest wearing a familiar name, and this project has already
    spent time on a test that had merely bee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
2026-08-02 Correct getInfo's deviceType and record what the log confirms
    deviceType comes back "Speaker", not "SPEAKER" as the doc claimed. Small,
    but a reader comparing output against a doc that says the wrong string has
    been handed a false negative.
    The startup log turned out to prove two things the design had only argued
    for, so both are now written down where they can be checked rather than
    believed.
    "Using StdoutSink (pipe) with format: F32" is the Hub's exact audio
    configuration accepted and active, which makes it the place to look if
    audio ever arrives at the wrong rate.
    "Mixing with softvol and volume control: Log(60.0)" is why volume from the
    phone reaches the speakers with no work from the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
2026-08-02 Announce librespot on the speakers' interface, not the VPN's
    Root cause, measured rather than guessed:
    InterfaceAlias InterfaceMetric ConnectionState
    Tailscale 5 Connected
    Wi-Fi 50 Connected
    librespot's --zeroconf-interface defaults to every interface, and a socket
    bound that way lets Windows choose where multicast goes — by route metric.
    Tailscale wins by a factor of ten, so the announcements left over the
    overlay to nobody.
    The symptom is precise and thoroughly misleading. The receiver is
    reachable at its address: a phone's browser gets a full JSON answer from
    /?action=getInfo. It is simply absent from Spotify's li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
2026-08-03 Add a script that measures which mode librespot is actually in
    The open question is whether librespot can be signed in and still
    announce itself, because that decides how cast points get set up: signed
    in means the device belongs to one account, announcing means anyone at the
    party can claim it, and the whole point of a speaker in a kitchen is the
    second one.
    Three checks, none needing a phone. Whether the zeroconf HTTP server is
    listening, which is the guest path and is closed if it is not. What
    getInfo says about activeUser, which is empty when unclaimed and carries
    the account when signed in — a local, scriptable answer to "is it signed
    in". And a one-shot multicast DNS query for _spot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
2026-08-03 Record the MAX98357A and CX31993 as Consumer output options
    Both are next-step hardware rather than anything bought, so this is a note
    that stops them being re-derived, in the shape decision 8 already set: how
    a Consumer emits audio is a profile property, so these are additive.
    The MAX98357A is the interesting one. It is an I2S DAC and a 3 W Class-D
    amplifier in one part, so it replaces the PCM5102A and the amplifier that
    would have followed it — which makes the self-amplified receiver the
    cheaper of the two, about 70 SEK against 78. It removes a part rather than
    adding one.
    Its SD pin selects left, right or the average by voltage, and the note
    says to leave it alone. Decision 10 already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
2026-08-03 Separate being discovered from being claimed
    Chasing this as one problem is what cost the evening. It is two, reached
    by different routes, and only one of them is broken.
    Unclaimed, a receiver is known to the world only through its mDNS
    announcement, and becomes usable only when a Spotify client on the same
    network finds it and hands over credentials. Claimed — by that handover or
    by --enable-oauth — it registers with Spotify as a device on that account
    and appears wherever the account is used, with no multicast involved. The
    community reports the same thing from the other side: a device shows up in
    the list once it has been connected to at least once, and the Web API
    lists only recentl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
2026-08-03 Record the multicast leg beside the unicast measurements
    Every run in this document measures unicast RTP between two nodes.
    Discovery is multicast, travels by different rules, and one can be perfect
    while the other is broken — which is what an entire evening went into
    learning. It belongs here because the causes are network facts rather than
    Spotify facts, and they will resurface the first time anything else has to
    announce itself.
    Three findings and a non-suspect.
    A VPN interface can carry announcements away: a socket bound to 0.0.0.0
    lets the operating system pick the outgoing interface by route metric, and
    Tailscale held 5 against Wi-Fi's 50. The symptom is reachable-but-
    undiscoverab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
2026-08-04 The host could not hear: record the cause and stop it recurring
    Windows had classified a wired home LAN as Public, which switches off its
    built-in inbound mDNS rules. The receiver could send and could not
    receive, and every test all evening measured sending.
    The symptom is as misleading as symptoms get, and all of it was true at
    once: the receiver answers ?action=getInfo from a phone's browser, logs
    its announcements leaving on the right interface, replies to a direct
    query from another machine — and no phone can discover it. Discovery is a
    question that has to arrive, and none did.
    What finally showed it was watching what the host received rather than
    what it sent. With libmdns=trace a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
2026-08-04 Make librespot's mDNS backend a build input
    Evidence now points at libmdns rather than the network. On the same wired
    server, across the same switches and the same mesh, the phone discovers a
    Home Assistant VM using Avahi and does not discover librespot using
    libmdns. Same host, same path, same phone; the variable is the responder.
    It is also already known to have gaps: it does not answer the
    _services._dns-sd._udp meta-query that every mDNS browser uses to build
    its list, which is why the service was absent there too and why that
    absence proved nothing.
    librespot supports a second backend that hands the job to the system
    responder — Apple Bonjour on Windows — so the workflow takes the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
2026-08-04 Wire the PCM5102A, and say why the ADC can wait
    The boards arrived, so the wiring belongs in writing before it is done
    from memory at a bench.
    Match by pin name rather than position, because clone modules reorder the
    header. The three signal pins are deliberately the same ones the
    MAX98357A section already uses, so the firmware never has to know which
    output board is attached.
    Two pins account for almost every "wired correctly, no sound", and both
    get their own paragraph. SCK must be grounded — it is a system-clock input
    and grounding it selects the internal PLL, while floating it means the DAC
    never locks. XSMT is an active-low soft mute, so low or floating is a hard
    mute that is indist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
2026-08-04 Play received audio: I2S output on the Consumer
    The first firmware that can make a sound. A Consumer brings up an I2S
    output at boot, buffers what arrives and feeds the DAC from it, so the
    Hub's test tone reaches a speaker.
    Two clocks that nobody synchronised meet here. Packets arrive when the
    radio delivers them — 1.2 to 2.3 ms of jitter, occasionally in bursts —
    and the DAC consumes 48 000 frames a second forever. So received packets
    go into a ring and a separate task feeds I2S from it at the rate the
    hardware sets. The ring's depth is the playout delay and it is the price
    of not clicking: 20 ms by default, with 20 ms of DMA behind it.
    The conversion between the two formats is its ow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
    [main.c, oal_pcm.c, oal_pcm.h, oal_playout.c, oal_playout.h, oal_stream.h, oal_stream_consumer.c]
2026-08-04 Choose the I2S pins so the DAC wires with no crossed leads
    Both header orders are fixed — SCK BCK DIN LCK GND VIN on the PCM5102A,
    VUSB GND 3V3 D10 D9 D8 D7 on the XIAO — but which GPIO carries which
    signal is not, because the S3 routes I2S through its matrix. So the
    defaults are now picked to suit the boards rather than picked in order and
    left to the soldering iron.
    Rotate the DAC 180 degrees so VIN faces VUSB and it comes out as two
    straight power wires and three parallel diagonals, each stepping down one
    row because 3V3 has no counterpart on the DAC and absorbs the offset. That
    means swapping WS and DOUT from the previous defaults: BCLK stays on 7,
    DOUT moves to 8, WS to 9.
    SCK is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
2026-08-04 Document the PCM5102A's four configuration pins
    FLT, DEMP, XSMT and FMT decide whether this board makes a sound, and each
    appears twice: as a solder jumper on the back and as a through-hole on the
    left header. The header is much the easier of the two, because it carries
    A3V3 and AGND alongside the four pins — so XSMT to A3V3 is a jumper two
    rows apart on the same connector rather than a bridge across three
    surface pads the size of a grain of rice.
    The mapping is worth writing down because the silkscreen does not state
    it: the 1 2 3 4 on the front are H1L to H4L on the back, in order, and
    they are FLT, DEMP, XSMT, FMT.
    Boards vary in how they ship, so the advice is to measure rather than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
2026-08-04 A receiver has to sign in; discovery is not enough
    Two evenings of measuring the wrong thing end here. Current Spotify
    clients do not offer unclaimed zeroconf devices in their picker. A
    librespot that announces itself correctly, on a network that provably
    carries the announcement, is invisible to every Spotify client until it
    has authenticated.
    The proof was a client on the same machine as the receiver, over loopback,
    with no network involved at all — and still nothing in the list. The same
    receiver with --enable-oauth appeared immediately, beside the Google Cast
    devices and the account's other Connect endpoints, with a speaker icon and
    no Cast subtitle.
    Everything now fits, including th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
2026-08-04 Correct the standalone audio test: a file paces nothing
    The pipe backend has no clock. It writes as fast as it decodes and relies
    on whoever reads to pace it — a sound card does, and so does the Hub,
    which stops reading at 100 ms of buffered audio and lets the pipe fill.
    A file does not, so librespot finishes each track in about a second and
    races through the playlist. That is the flow-control mechanism visible by
    its absence, and it is worth recognising rather than mistaking for a fault.
    So the guidance to expect 3.5 MB per ten seconds was wrong: with a file
    redirect, elapsed time means nothing. Total bytes against track duration
    does. F32 stereo at 44.1 kHz is 352,800 bytes per second o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
2026-08-04 Record the audio-key failure and the fix that worked
    Every track loading and being skipped a second later, with "error audio
    key 0 2" and "Unable to load key", is librespot issue #1649 — open
    upstream, no documented workaround, reported against 0.7.0 and 0.8.0 and
    triggered by OAuth with Spotify Connect playback. It is hitting Music
    Assistant, Home Assistant and spotify-player too.
    Deleting the credential cache and signing in again fixed it here. The keys
    worked immediately and every track loaded cleanly afterwards. That is
    worth writing down precisely because the upstream issue documents no fix,
    and it costs one browser sign-in to try.
    Also records what the pipe test actually looks like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
2026-08-04 Spotify audio verified as far as the pipe
    933 MB captured and played back as f32l, 2 channels, 44100 Hz —
    recognisable music at the right pitch and speed. Those are precisely the
    parameters PcmDecoder and LibrespotOptions assume, so the decode path is
    now checked against real Spotify audio rather than only against its own
    unit tests. Wrong byte order would have been static and a wrong channel
    count would have been chipmunks; it was neither.
    Two links remain unverified and they sit at opposite ends of the chain:
    the Hub consuming that pipe in place of a file, and a node playing what
    comes out.
    Claude-Session: https://claude.ai/code/ses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
2026-08-04 Sign-in verified on the phone; size the cost honestly
    Signing in registers the device against the account, and it appears on
    every client afterwards — desktop and phone both confirmed. The machine
    that did the authorising is not special, which is what makes one sign-in
    per cast point enough.
    The cost section was written starkly and needed proportion. A cast point
    does belong to the account that signed it in, but two ordinary things
    reduce that to a footnote for most homes: a shared account covers a
    household, and Spotify Jam covers a party, since guests join the host's
    session rather than claiming a speaker.
    What genuinely remains is the household where people keep separate
    accounts. Tha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
2026-08-05 Record the lossless ceiling and the control surface idea
    Spotify's lossless tier does not reach third-party Connect devices at all
    — issue #1583. Every Connect endpoint gets 320 kbps Ogg Vorbis whatever it
    can decode. Not DRM and not a gap in librespot, which decodes FLAC
    happily; the data is simply not sent, so a fork cannot fix it any more
    than a fork can remove the sign-in.
    Worth stating what that means for the profile rather than leaving it
    implied. Through this source the ceiling is 320 kbps Vorbis, so L24 at
    48 kHz costs 2.3 Mbit/s of air for content that will never fill it —
    losing nothing and gaining nothing. The profile is sized for the best
    source the system will carry, a turn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
2026-08-05 The wall panel as Controller host, and what that does not buy
    Decision 9 already made room for this: the Controller is a small role and
    the Hub is merely a device that hosts it, verified on hardware in both the
    house case and the party case. A panel holding that role is a third host
    for a role that already moves, and it makes a house with no PC at all
    coherent — speakers, a source, and a screen by the door.
    The boundary is worth being blunt about, because "put the Controller on
    the wall panel" sounds like it removes the PC entirely. It removes the PC
    only from deployments that never needed a streaming service. A panel can
    hold discovery, the peer table, the election, the cast points and t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
2026-08-05 Settle clock sync and the wire sample rate
    Decision 12: no NTP. A common clock beats a correct one, NTP's
    resolution is an order of magnitude short of a stereo pair, and the
    three mechanisms that do the job — offset measurement, a playout
    contract on RTP timestamps, APLL rate matching — are ours to build.
    Records honestly that none of it exists yet; what exists is the ring's
    drift counters, which are the error signal a servo would use.
    Decision 13: 48 kHz stays the only rate on the wire, with the rate
    still carried as a field. The fidelity argument for native 44.1 does
    not survive measurement, and 44.1 has no integer-millisecond packet
    time that fits an Ethernet frame. Closes the questi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
2026-08-05 Note the one seam a stereo pair will need widened
    oal_stream_sink_t passes payload and frame count but not the packet's
    RTP timestamp, so playout cannot know which frames it is holding. That
    is the only place the current shape resists decision 12's playout
    contract; recorded next to drift correction, and the drift entry's
    stale reference to decision 2 corrected to 12.
    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
2026-08-05 Record the per-node latency offset setting
    Two PA speakers of different models sit a fixed few milliseconds apart
    through their own DSP. That is not drift and no servo corrects it; it
    needs a signed trim per node, set at install, living beside decision
    10's channel profile in NVS and in the portal.
    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
2026-08-05 Record esp_asrc as the alternative to APLL rate matching
    Decision 12's third mechanism has two shapes: trim the clock, or
    resample by the ratio you are off by. espressif/esp_asrc is the second,
    so name it and say why the clock trim still wins here — both candidate
    DACs are slaves, so we own the playback clock, and ASRC would cost
    arithmetic on every sample on every consumer forever.
    Three unknowns recorded with it: whether the ratio can be steered at
    runtime, software-path CPU on an S3, and the licence.
    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
2026-08-05 Record why SCK is grounded on the DAC board
    The first build carried ground across from the XIAO instead and the arc
    landed one hole short, on D7: a finished-looking joint, a harmless GPIO
    short, and SCK still floating. Silence, which is also the symptom of
    every other fault on this board.
    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
2026-08-05 Fix the dropouts in the first hardware playout test
    Three faults, found from the node's own counters and the serial log.
    silenceFrames could never move. It was incremented only on a partial
    chunk, but the ring fills and drains in whole 240-frame packets, so the
    one counter meant to reveal starvation read zero while the ring starved
    several times a second. underruns now counts occurrences, silenceFrames
    counts silence actually inserted, and a re-prime logs as a warning.
    Playout re-primed on the first empty chunk, reasoning that an empty ring
    means the stream stopped. For the first 5 ms a stopped stream, a Wi-Fi
    retry and a sender that left a gap are indistinguishable, so a 5 ms gap
    in arriv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
    [oal_playout.c, oal_playout.h]
2026-08-05 Make the playout report both clocks and the buffer's swing
    The counters say a buffer is failing but not why: silence and drops look
    the same whether the ring is swinging under a bursty sender or walking
    steadily to an edge under a rate mismatch. Two samples from hardware
    gave -905 and -883 ppm, which is suspiciously consistent for something
    that should be crystal tolerance, while the ring sat near full — the two
    readings disagree, and inference cannot settle it.
    So measure instead of infer. Every five seconds the node now logs frames
    arriving per second against frames written to the DAC per second, their
    difference in ppm, and the minimum, current and maximum fill across the
    interval. Equ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
    [oal_playout.c]
2026-08-05 Write the whole chunk to I2S, not part of it
    A short write from i2s_channel_write returns ESP_OK, and the tail was
    being dropped on the floor: samples already taken out of the ring, with
    no counter recording them. The ring then looks like it is being drained
    faster than the DAC plays it, which is indistinguishable from a fast
    playback clock — the exact ambiguity the new trace exists to resolve,
    so it had to go before the measurement means anything.
    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
    [oal_playout.c]
2026-08-05 Give the send loop its own thread
    Hardware said the sender, not the radio. With the node back at RSSI -50
    and not one packet lost, the node's trace showed arrival at 47232 Hz for
    one five-second window and 48623 Hz for the next: the Hub falling about
    80 ms behind and then catching up in a lump. The playout ring swings the
    full width of itself on that, hitting both ends.
    The loop ran on the thread pool and awaited inside itself, so every
    iteration's continuation queued behind the rest of the Hub's work --
    librespot's pipe reader alone moves 176 KB a second through that pool.
    It now runs on a dedicated LongRunning thread at AboveNormal priority
    with synchronous sends, so nothing else in the p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
2026-08-05 Have the Hub say when its own send loop was late
    The node's trace times arrival, which is when the node read the socket
    -- so a bunch of packets arriving together cannot distinguish the Hub
    sending late from the node reading late, and those need different
    fixes. The send loop now measures how far behind its own clock each
    iteration wakes, keeps the worst, and logs anything over 20 ms.
    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
2026-08-05 Record how the first playout dropouts were actually found
    Three more faults after the first fix, none visible in the counters and
    all found by making the node report both clocks every five seconds.
    The DAC's clock was never wrong. A consistent -890 ppm across two
    samples looked exactly like the drift decision 12 describes, and would
    have justified building rate matching; it was a short write from
    i2s_channel_write discarding the tail of a chunk, uncounted. A ring
    drained by an invisible leak reads as a fast playback clock.
    It was not the weak Wi-Fi either -- moving the node from -80 to -47 dBm
    changed nothing, with zero packets lost at both. Late is not lost.
    It was the Hub's send loop qu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
2026-08-05 Size the playout target against the worst gap, not the average
    With the send loop on its own thread the ring stopped slamming its
    limits and settled near its target with a swing of about 35 ms either
    way -- but gaps of 60 to 70 ms still turned up occasionally, and a 60 ms
    target cannot survive one of those. Now 100 ms of target inside 200 ms
    of ring, which costs 15 KB and about 40 ms of extra latency.
    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
2026-08-05 Record that the Hub is not the source of the remaining holes
    Its own counter: worst lateness 25 ms over 10348 packets, fourteen late
    wakes, while the node saw 105 ms holes in the same period. The
    thread-pool theory was right for the large stalls and wrong for these,
    and one field settled it rather than another evening of inference --
    which is the argument for both ends measuring against their own clock.
    Nothing is lost, so something buffers packets and releases them
    together. Suspect recorded: mesh access points leaving the channel to
    scan. Untested.
    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
2026-08-05 Note that the Hub was on a laptop over Wi-Fi for these measurements
    Which makes it the first suspect for the remaining holes, ahead of the
    mesh. Every packet crossed the air twice, and the Hub's lateness counter
    times the send call -- before the adapter -- so the laptop's own radio
    and its power management sit outside the number that exonerated the Hub.
    Moving to the wired server removes that hop and is the cheaper test.
    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
2026-08-05 Stop the node running out of sockets
    Seen on hardware: httpd_accept_conn refusing every connection with
    errno 23, esp-tls unable to create a socket, repeating forever. lwIP
    gives the node about seven sockets and nothing was ever reclaiming
    them, so once clients had taken them all the whole control plane went
    dark -- no status, no portal, no OTA -- while audio kept playing.
    Both ends now behave. The node purges its least recently used
    connection instead of refusing the new one, which is the right trade
    when every request it serves is short. The Hub stops hoarding: .NET
    keeps pooled connections alive for minutes, which is correct for a web
    service and wrong against a device with seven sockets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
2026-08-05 Give the node room to breathe on sockets, and say when a join fails
    A join that cannot connect said nothing, so a node retrying a dead
    Controller address every five seconds -- exactly what a Hub moving to
    another machine leaves behind -- looked identical to a node with
    nothing to do. It logs now.
    lwIP's ten sockets also went up to sixteen. Running an HTTP server, an
    HTTP client, RTP and discovery on ten is thin, and running out takes
    the entire control plane down while audio keeps playing, which is a
    failure that hides itself.
    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
2026-08-05 Send RTP from the interface that can reach the receiver
    The tone played from a laptop and was silent from the server, with the
    Hub counting packets sent and the node reporting nothing received.
    Both were telling the truth: the audio socket bound to 0.0.0.0 and let
    the routing table pick an interface, and the server has Tailscale and a
    Hyper-V switch alongside its LAN.
    LocalAddressSelector was written for exactly this and was already used
    for OTA and for librespot's zeroconf; the audio socket never used it.
    It now binds to the address whose subnet contains the receiver, and
    logs which one it chose -- or warns when none matches and the routing
    table is deciding.
    A machine with one interface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
2026-08-05 Record the clean run: the holes were the laptop's wireless hop
    On the wired server, with the audio socket bound to the right
    interface, the node reports minutes of +0 ppm with no underruns, no
    drops and no silence, the ring sitting at 105 ms against its 100 ms
    target. What remains is one short window coinciding with a 5 dB drop in
    signal, and the window after it absorbed a larger deficit without an
    underrun -- a buffer working, not a fault.
    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
2026-08-05 Ask the Hub's runtime for short GC pauses, not high throughput
    The send loop's own counter on the wired server: worst stall 80 ms and
    1631 late wakes in three minutes, against 25 ms and fourteen on an idle
    laptop. Inaudible only because the node's 100 ms buffer covers 80 ms,
    which is less margin than it sounds.
    The Web SDK defaults to Server GC, which collects less often and pauses
    longer. That trade is wrong here -- this Hub sends 200 small packets a
    second and serves a page nobody looks at, so it has no throughput to
    protect and every pause is a hole in the audio.
    Whether the remaining stalls are GC or the hypervisor on that machine
    is not yet known; worstStallMs before and after will sa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
2026-08-05 Walk the playout fill back down towards its target
    Nothing did. Sender and DAC run at the same average rate, so wherever a
    burst leaves the ring is where it stays -- measured creeping from 105 ms
    to 190 ms of a 200 ms ring over a few minutes and staying there. That
    depth is not safety: with 10 ms left above it the next burst overflows
    while the deep gaps still empty it, so the ring drops and starves at
    once. At its target it did neither for minutes together.
    One frame per 5 ms chunk when the fill sits above target plus a quarter
    of the headroom -- about 4000 ppm, so 100 ms of excess is gone in half a
    minute, and a single frame dropped at 48 kHz is inaudible. The crudest
    form of decision 12'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
2026-08-05 Measure the Hub to node hop, the gap decision 11 called the important one
    Wired Hub, one S3 with a DAC, two hops: 71,901 packets, none lost, no
    gaps, 2.33 ms jitter over six minutes. Higher jitter than the best
    node-to-node runs and expected to be -- a general-purpose OS schedules
    the sender -- but less than half what the same Hub produced before its
    send loop got its own thread.
    Recorded with the two things that make it easy to misread: payload
    errors are meaningless against a tone, and zero loss did not mean clean
    audio. This is the first run in the series with a DAC on the end, and
    the same link that lost nothing still dropped out audibly until the
    playout buffer and the sender's schedul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
2026-08-05 Refuse two cast points with the same name
    Creating "Party" twice made two, because only the id was being kept
    unique. The id is internal; the name is what Spotify shows, so the
    picker offers two identical entries with no way to tell them apart --
    and each has its own credentials directory, so one can be signed in and
    the other not. Seen while setting up the first real cast point.
    Create and rename now return 409 with a plain message. Comparison is
    case- and whitespace-insensitive, because the clash is about what a
    person reads in a device picker rather than what they typed.
    Claude-Session: https://claude.ai/code/session_013Ep1dr3eARSjFW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
2026-08-05 Say to stop the sign-in librespot once it has signed in
    Leaving it running is the confusing failure, not an untidy one: the
    terminal instance keeps the cast point's name, so Spotify offers it
    instead of the Hub's and plays into a console. librespot then reports
    that Windows stdio in console mode cannot write non-UTF-8 byte
    sequences, which reads like a failed sign-in and means only that the
    audio had nowhere to go -- --backend pipe writes raw PCM to stdout, and
    the Hub is the thing that redirects it.
    Hit while setting up the first real cast point. Now in both the log
    line the Hub prints and LIBRESPOT.md.
    Claude-Session: https://claude.a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
2026-08-05 Spotify to a speaker, end to end, for an hour
    Run 17: 504,886 packets, six lost in three gaps of two, 1.33 ms jitter
    over 46 minutes -- lower than the tone run, which is worth not
    over-reading. Decision 11 moves from implemented to verified on
    hardware.
    Recorded with the two numbers only the Hub can see: the source ran dry
    for about 0.7 s across the hour, almost certainly at track boundaries,
    and the send loop was still descheduled for up to 85 ms against a
    100 ms playout target.
    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
2026-08-05 Seed a new cast point from an existing sign-in
    Tested on hardware: a second cast point given a copy of the first's
    credentials.json appeared in Spotify's picker and played, with no
    browser round trip of its own. The credential authenticates the
    account, not the device -- each instance still generates its own device
    id and shows as its own entry.
    So the Hub does the copy itself and "sign in to each room" stops being
    a setup step. A house gains rooms one at a time and a party gains them
    all at once with someone waiting, so the difference is not small.
    Copied rather than shared: librespot writes that path, and several
    processes writing one file loses every room's login at once instead of
    one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
2026-08-06 Choose internet radio as the next source, and record its shape
    The cheapest strong source left and the only one that can be lossless:
    Radio Paradise, Linn and Naim serve FLAC over HTTP, so the ceiling is
    the station's rather than the protocol's, where Spotify caps every
    Connect device at 320 kbps Vorbis regardless of what it can decode.
    Everything downstream already exists and is now proven on hardware, so
    this is fetch, decode, hand over PCM. Records the one real decision --
    Media Foundation before ffmpeg, because a source needing no extra
    download works the first time -- and the two things that bite before
    any decoder does: playlist indirection, and HLS stations being a client
    rather than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
2026-08-06 Capture line input through an I2S ADC
    The Analog Source half of the system, which did not exist: the producer
    synthesised every payload and nothing had ever read an I2S input.
    oal_capture mirrors oal_playout, including the part that mattered most
    today -- a rate and a fill reported together every five seconds, so a
    buffer that swings can be told from one that drifts without a night of
    inference. Its ring is 40 ms against playout's 200, because they are
    sized against opposite things: a playout buffer covers the largest gap a
    distant sender can leave, while this covers the jitter of a task on the
    same chip, and every frame it holds is delay between the needle and the
    speaker that nothing down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
    [main.c, oal_capture.c, oal_capture.h, oal_pcm.c, oal_pcm.h, oal_rtp.h, oal_stream.h]
2026-08-06 Record XIAO + PCM5102A measurements for the speaker-dongle receiver
    Caliper readings from the actual boards: XIAO 21.5x18mm with a 9x3.2mm
    USB-C protruding 1.5mm, PCM5102A 17.25x32mm with a 5.1mm jack barrel
    also protruding 1.5mm, and an 18x38mm adhesive-backed antenna sheet on
    a U.FL pigtail. Also settles two of the open design decisions for this
    build: boards side by side with the connector edges flush at one end
    (the real install routes both cables out one tight gap behind a
    speaker), and power leaning towards a 2-wire feed into a panel-mount DC
    jack rather than the XIAO's onboard USB-C.
    Z-axis numbers (PCB thickness, component heights, jack barrel height)
    and a couple of ambiguous readi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
2026-08-06 Fill in Z-heights, mounting, power and antenna details for the speaker-dongle
    Component heights, PCB thicknesses and board-to-board gap now recorded
    for both boards, both confirmed to have no mounting holes (retention
    will be glue) and nothing on their undersides. Power is settled on a
    2-wire feed into a panel-mount USB-C jack rather than the XIAO's
    onboard port, kept opposite or 90 degrees from the audio jack to keep
    it away from the analog signal. Antenna pigtail corrected to 55mm (was
    misread as 5.5mm), landing mid-sheet rather than at a corner.
    Still open: which end of the assembly the two boards' header rows face
    (flush connector edges vs. HARDWARE.md's opposite-ends wiring diagram)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
2026-08-06 First-draft boards.scad and coupon.scad for the speaker-dongle receiver
    The assembly photo confirmed the actual topology: the two boards sit
    end to end with their header rows facing each other across the gap
    (docs/HARDWARE.md's rotate-180 wiring), not side by side with the
    connector edges flush as first assumed. The DAC's jack ends up at the
    far end, the XIAO's USB-C on its east short edge near the gap, and the
    antenna pigtail off the south-west corner.
    boards.scad turns everything gathered in MEASUREMENTS.md into one
    shared coordinate system, with a toggle for the still-open power
    decision (external 2-wire jack vs. the XIAO's own USB-C).
    coupon.scad is a floor plus two short wall stubs ca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
    [boards.scad, coupon.scad]
